reckashura/Projet-Conception-des-syts-mes-digitaux/README.md

# Projet-Conception-des-syts-mes-digitaux
Ce projet consiste à développer un système automatisé de contrôle d’un passage à niveau. Il gère les barrières et feux de signalisation pour assurer la sécurité des trains, véhicules et piétons via des signaux sonores, lumineux et des messages d’avertissement.
