reckashura/Projet-Conception-des-syts-mes-digitaux/videoeducative_lien.docx

Lien d’accès à la vidéo éducative :

videoeducative_Auger_Cliche_Toussaint.mp4 (https://uqoca-my.sharepoint.com/:v:/r/personal/augl07_uqo_ca/Documents/Sessions/Automne%202024/gen1243/projet/videoeducative_Auger_Cliche_Toussaint.mp4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)
